SYSC4805/project-l2-g2/(commit log)

2025-10-27 Add motor integration test code to README
    Added motor control code for integration testing.
2025-11-03 Refactor motor control code for Arduino
2025-11-03 Refactor motor control and speed calculation logic
    Updated motor control functions to accept speed parameters and enhanced encoder reading and speed calculation features.
2025-11-15 Add HC-SR04 ultrasonic sensor example sketch
2025-12-01 Add main Arduino code for robot control
    This commit introduces the main Arduino code for controlling a robot with various sensors and motors. It includes state management for navigation, obstacle detection, and line following.
2025-12-01 Add magnetometer calibration code
2025-12-04 Add MotorIntegration test program
2025-12-04 Add MotorControl file for motor control logic
2025-12-04 Update and rename arduino_code.cpp to main.cpp
2025-12-04 Add Gyroscope and Magnetometer sensor unit test
    This file contains a unit test for the IMU and magnetometer sensors, initializing them and reading their values.
2025-12-04 Add WDT unit test for watchdog logic simulation
    This unit test simulates the watchdog timer logic by testing normal operation and system crash scenarios.
2025-12-04 Update README to reflect project structure changes
    Removed references to UltrasonicSensor and WDTtest from the project structure.
